wmhunter96/Goma/hardware/pcb/devkit-carrier-v1/sesame-devkit-carrier.step

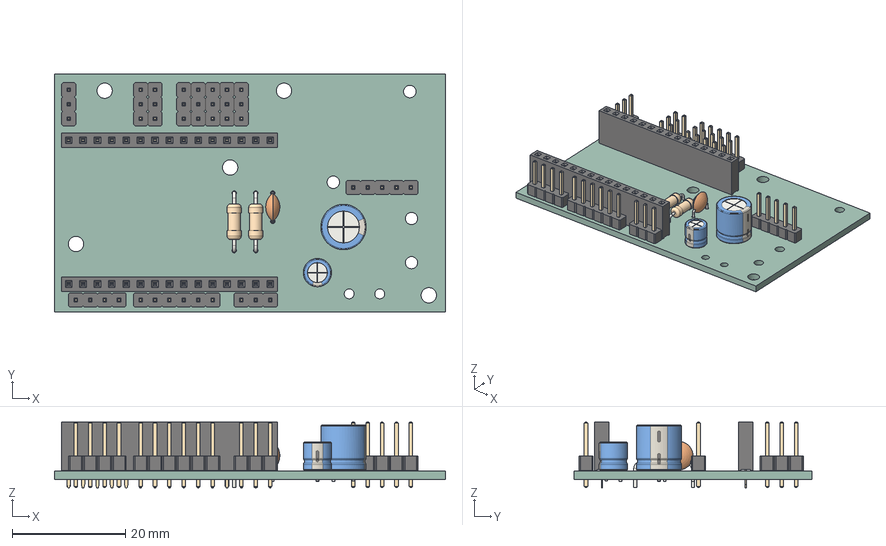
[picture p3: CAD file, 2026-10-20]
hardware/pcb/devkit-carrier-v1/sesame-devkit-carrier.step
69.0 x 42.0 x 11.6 mm
C_Disc_D50mm_W25mm_P500mm
PinHeader_1x04_P254mm_Vertical
PinHeader_1x06_P254mm_Vertical
PinHeader_1x03_P254mm_Vertical x 9
R_Axial_DIN0207_L63mm_D25mm_P1016mm_Horizontal x 2
PinHeader_1x05_P254mm_Vertical
CP_Radial_D80mm_P350mm
PinSocket_1x15_P2.54mm_Vertical x 2
CP_Radial_D50mm_P250mm
sesame-devkit-carrier_PCB
