wmhunter96/Goma/hardware/pcb/devkit-carrier-v1/preview/schematic.pdf

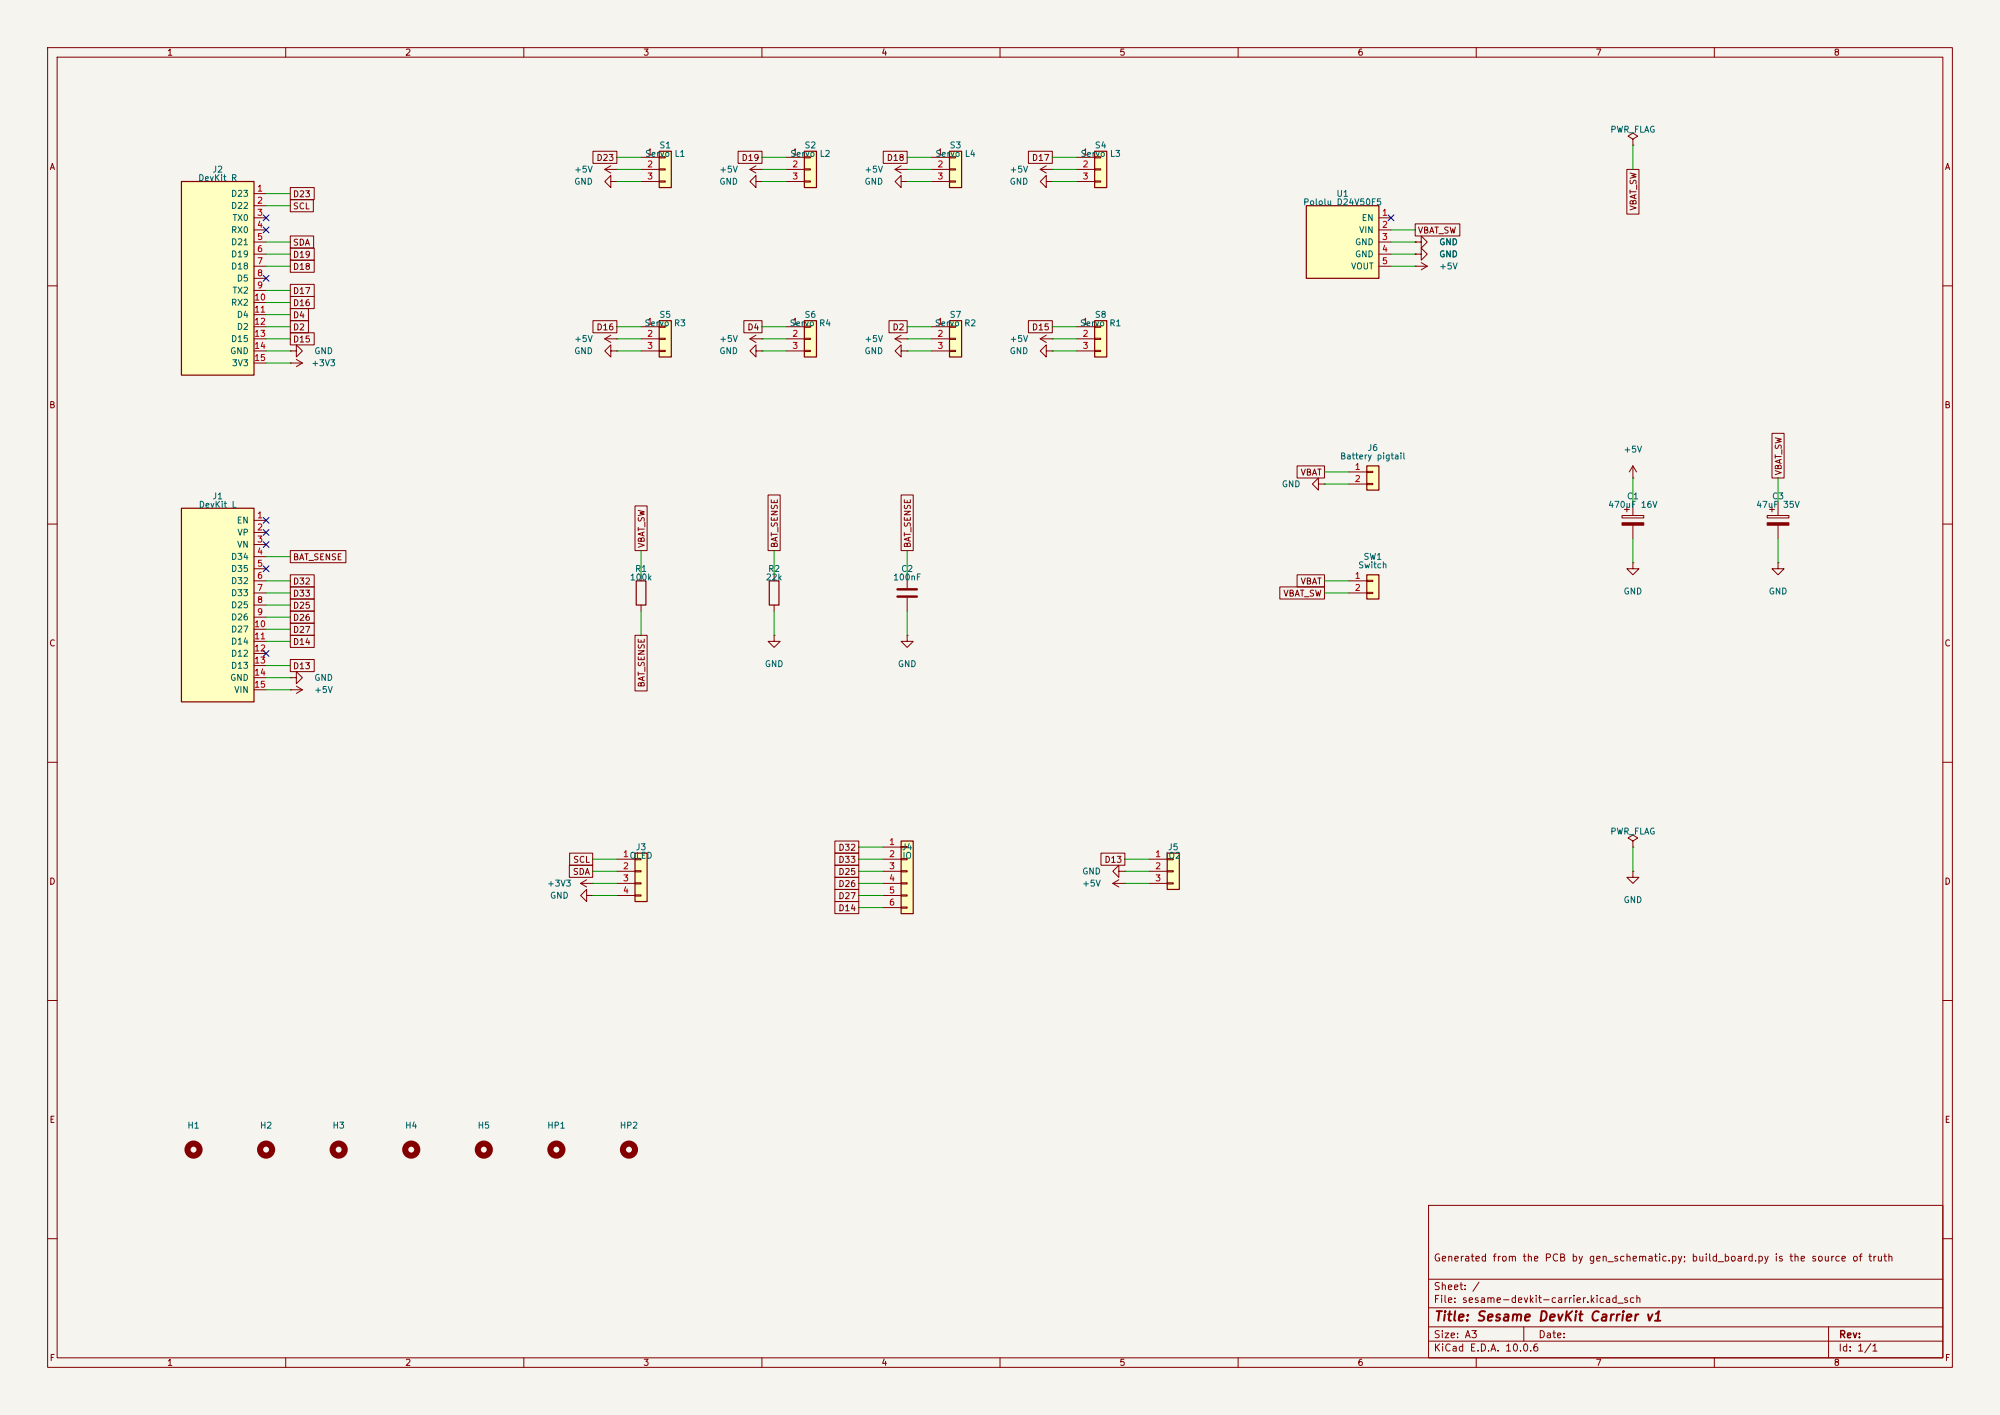
[picture p4: page 1]

Generated from the PCB by gen_schematic.py; build_board.py is the source of truth

Sheet: /
File: sesame-devkit-carrier.kicad_sch
Title: Sesame DevKit Carrier v1

Size: A3 | Rev: | F Date:
KiCad E.D.A. 10.0.6 | Id: 1/1
