wmhunter96/Goma/hardware/pcb/devkit-carrier-v1/preview/bottom_layers.pdf

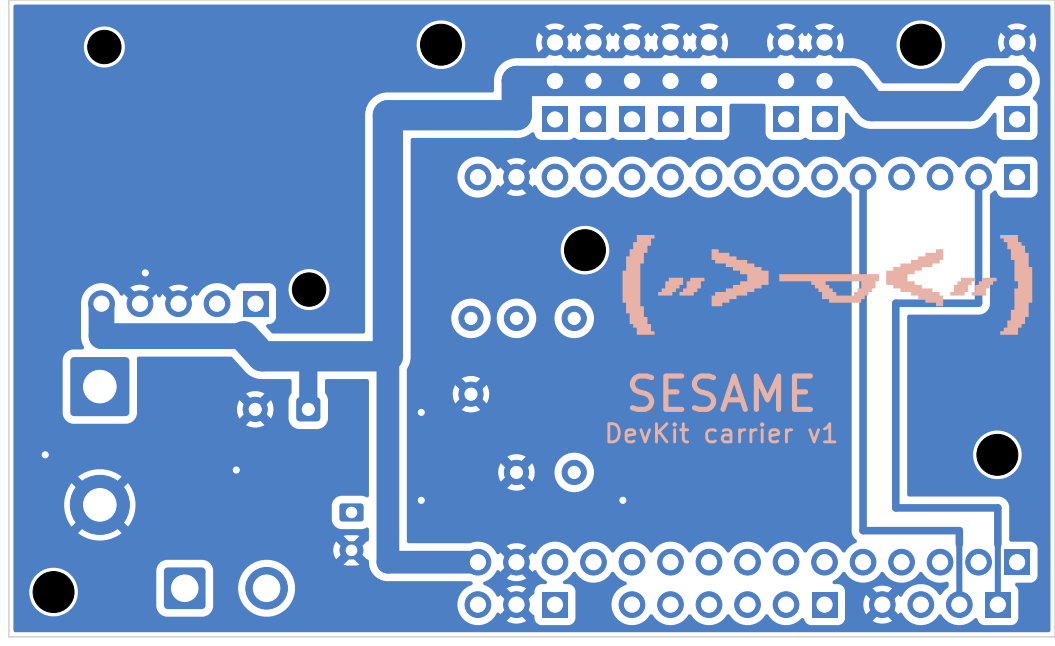
[picture p5: page 1]
