wmhunter96/Goma/hardware/pcb/devkit-carrier-v1/preview/template_1to1.pdf

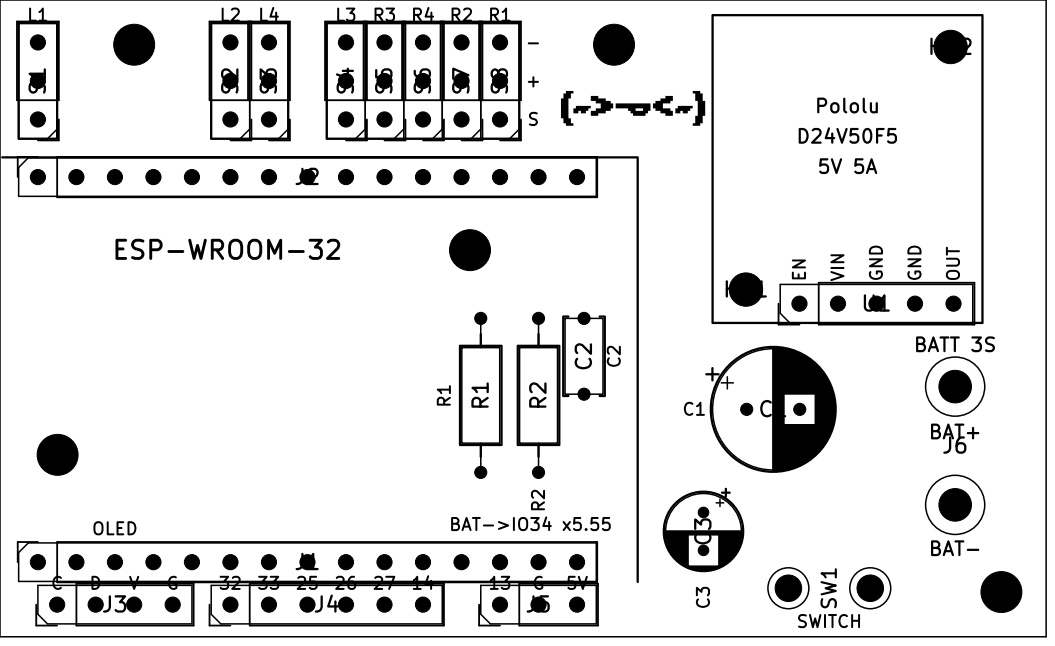
[picture p6: page 1]
