wmhunter96/Goma/hardware/pcb/devkit-carrier-v1/preview/top_layers.pdf

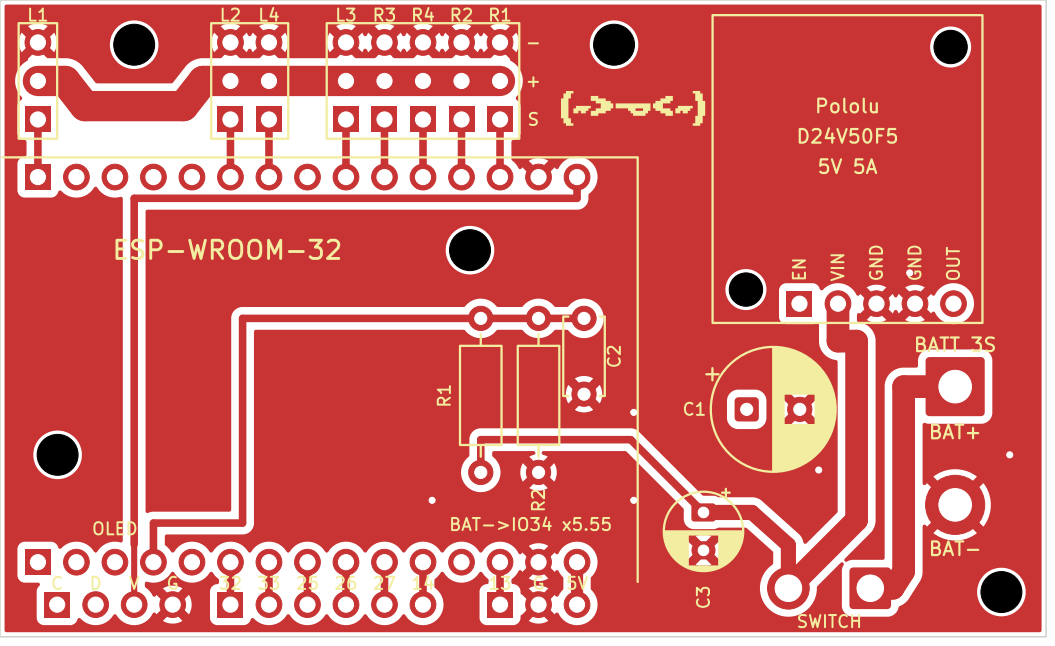
[picture p7: page 1]
