wmhunter96/Goma/hardware/pcb/devkit-carrier-v1/sesame-devkit-carrier.kicad_pcb

## KiCad design hardware/pcb/devkit-carrier-v1/sesame-devkit-carrier.kicad_pcb (2026-10-20)

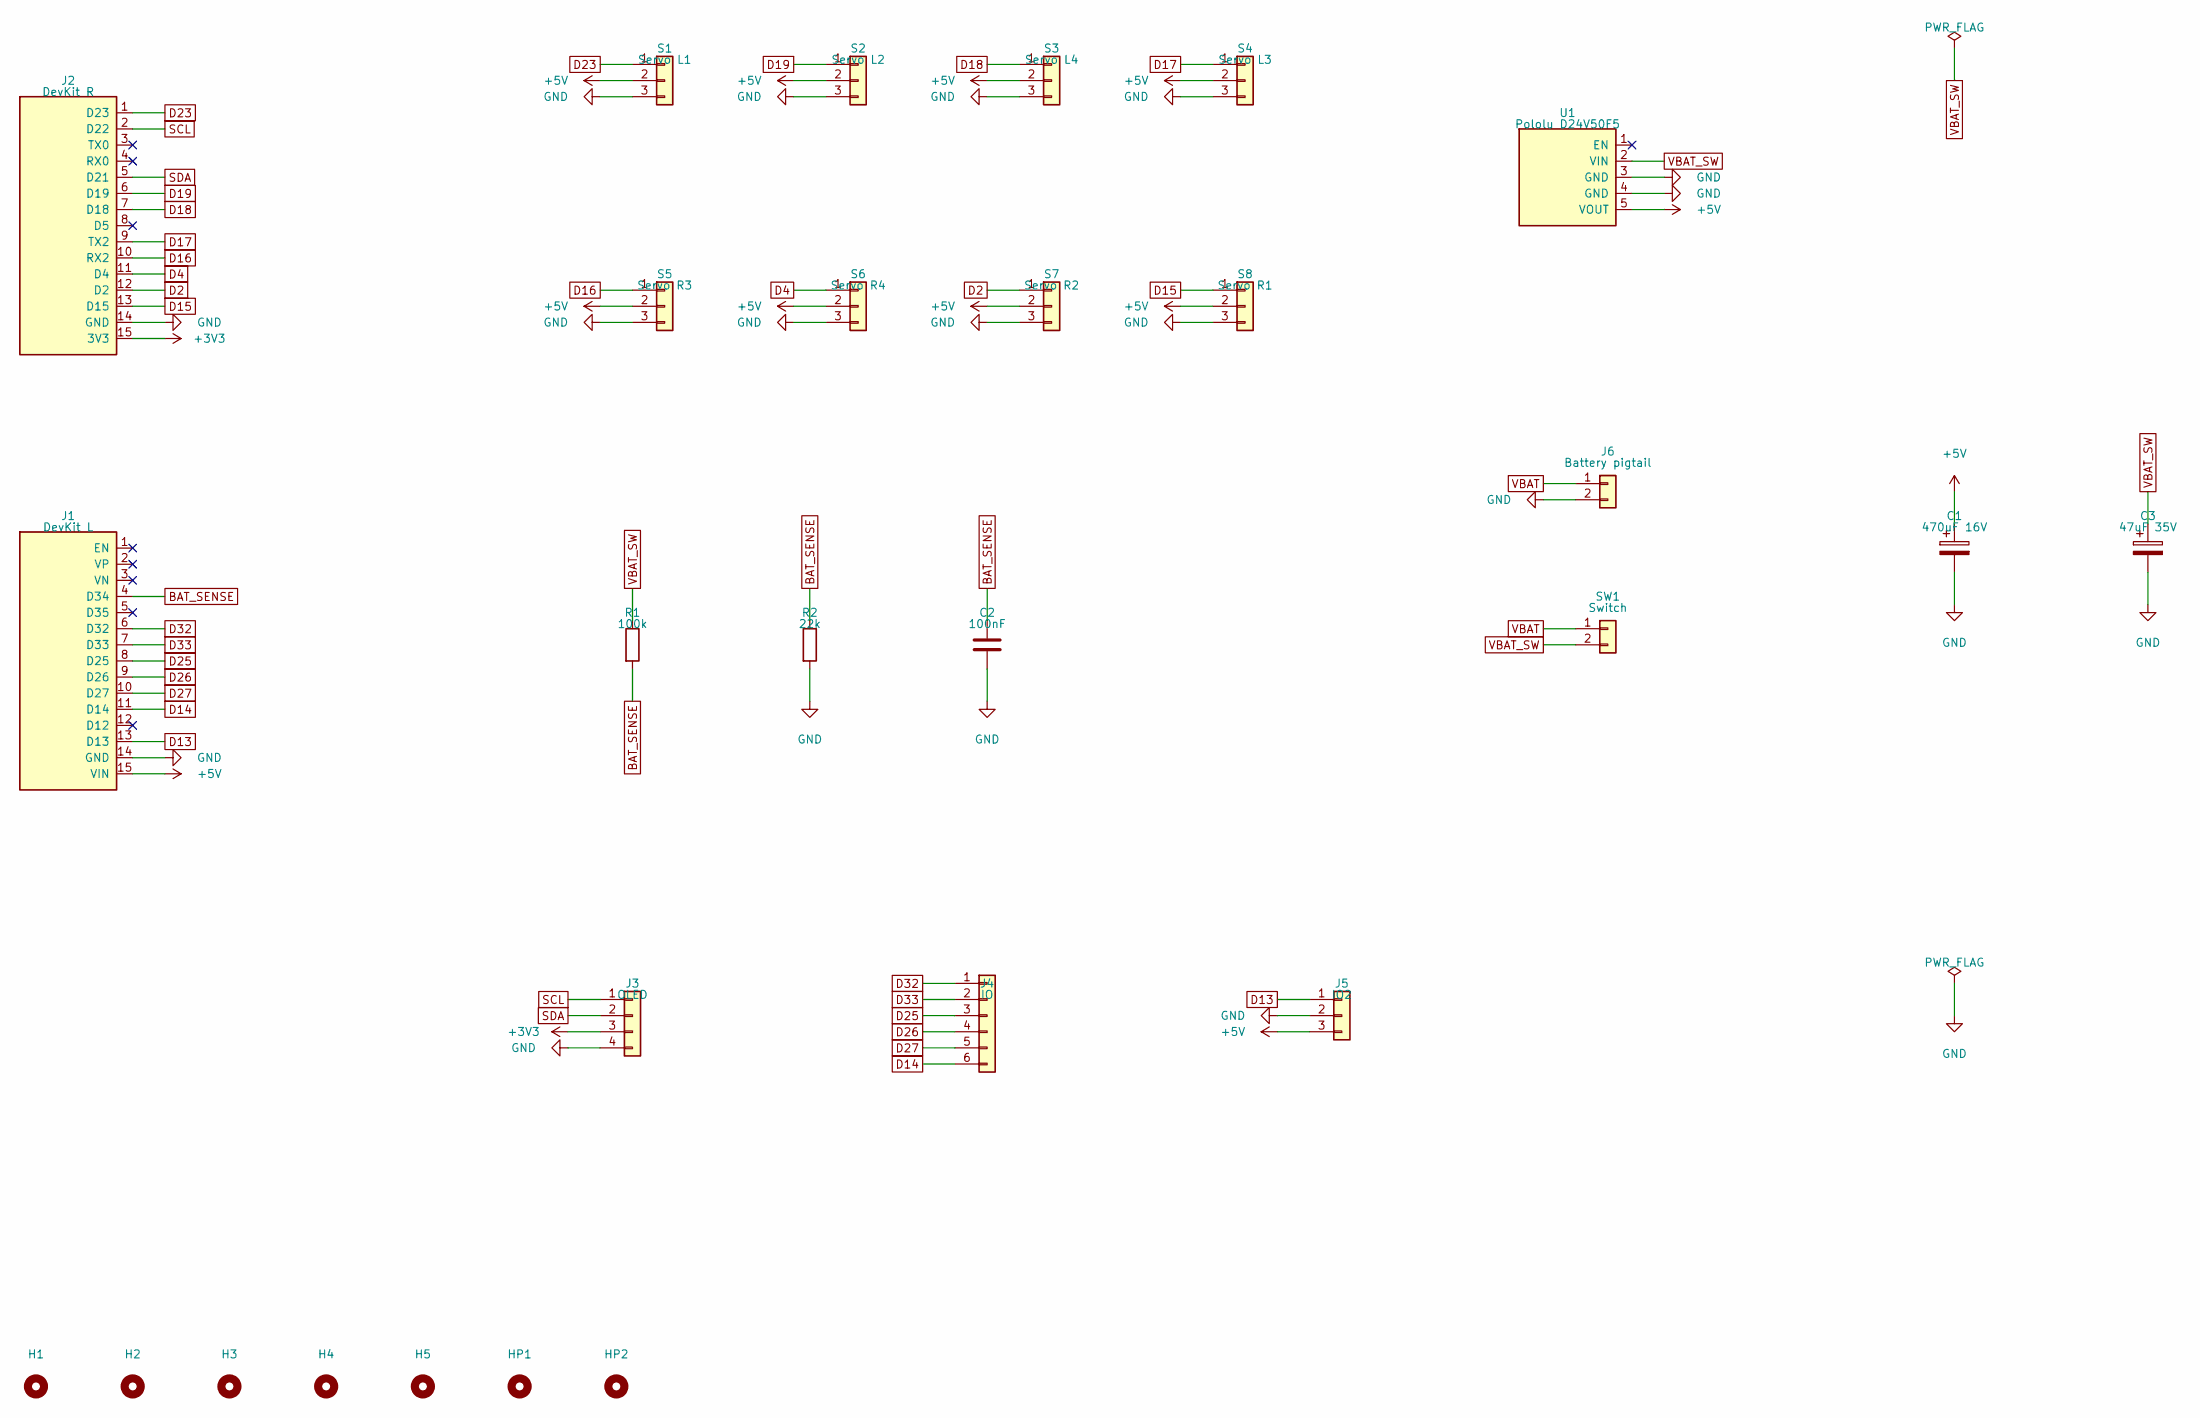
[picture p8: schematic sesame-devkit-carrier.kicad_sch, Sesame DevKit Carrier v1]

Parts:
C1: 470uF 16V; CP_Radial_D8.0mm_P3.50mm
C2: 100nF; C_Disc_D5.0mm_W2.5mm_P5.00mm
C3: 47uF 35V; CP_Radial_D5.0mm_P2.50mm
H1, H2, H3, H4, H5: MountingHole_2.7mm_M2.5
HP1, HP2: MountingHole_2.2mm_M2
J1: DevKit L; PinSocket_1x15_P2.54mm_Vertical_GroupSilk
J2: DevKit R; PinSocket_1x15_P2.54mm_Vertical_GroupSilk
J3: OLED; PinHeader_1x04_P2.54mm_Vertical_GroupSilk
J4: IO; PinHeader_1x06_P2.54mm_Vertical_GroupSilk
J5: IO2; PinHeader_1x03_P2.54mm_Vertical_GroupSilk
J6: Battery pigtail; SolderWire-1.5sqmm_1x02_P7.8mm_D1.7mm_OD3.9mm
R1: 100k; R_Axial_DIN0207_L6.3mm_D2.5mm_P10.16mm_Horizontal
R2: 22k; R_Axial_DIN0207_L6.3mm_D2.5mm_P10.16mm_Horizontal
S1: Servo L1; PinHeader_1x03_P2.54mm_Vertical_GroupSilk
S2: Servo L2; PinHeader_1x03_P2.54mm_Vertical_GroupSilk
S3: Servo L4; PinHeader_1x03_P2.54mm_Vertical_GroupSilk
S4: Servo L3; PinHeader_1x03_P2.54mm_Vertical_GroupSilk
S5: Servo R3; PinHeader_1x03_P2.54mm_Vertical_GroupSilk
S6: Servo R4; PinHeader_1x03_P2.54mm_Vertical_GroupSilk
S7: Servo R2; PinHeader_1x03_P2.54mm_Vertical_GroupSilk
S8: Servo R1; PinHeader_1x03_P2.54mm_Vertical_GroupSilk
SW1: Switch; SolderWire-1sqmm_1x02_P5.4mm_D1.4mm_OD2.7mm
U1: Pololu D24V50F5; PinHeader_1x05_P2.54mm_Vertical_GroupSilk

Connections:
+3V3: J2.15 (3V3), J3.3
+5V: C1.1, J1.15 (VIN), J5.3, S1.2, S2.2, S3.2, S4.2, S5.2, S6.2, S7.2, S8.2, U1.5 (VOUT)
BAT_SENSE: C2.1, J1.4 (D34), R1.2, R2.1
D2: J2.12 (D2), S7.1
D4: J2.11 (D4), S6.1
D13: J1.13 (D13), J5.1
D14: J1.11 (D14), J4.6
D15: J2.13 (D15), S8.1
D16: J2.10 (RX2), S5.1
D17: J2.9 (TX2), S4.1
D18: J2.7 (D18), S3.1
D19: J2.6 (D19), S2.1
D23: J2.1 (D23), S1.1
D25: J1.8 (D25), J4.3
D26: J1.9 (D26), J4.4
D27: J1.10 (D27), J4.5
D32: J1.6 (D32), J4.1
D33: J1.7 (D33), J4.2
GND: C1.2, C2.2, C3.2, J1.14 (GND), J2.14 (GND), J3.4, J5.2, J6.2, R2.2, S1.3, S2.3, S3.3, S4.3, S5.3, S6.3, S7.3, S8.3, U1.3 (GND), U1.4 (GND)
SCL: J2.2 (D22), J3.1
SDA: J2.5 (D21), J3.2
VBAT: J6.1, SW1.1
VBAT_SW: C3.1, R1.1, SW1.2, U1.2 (VIN)

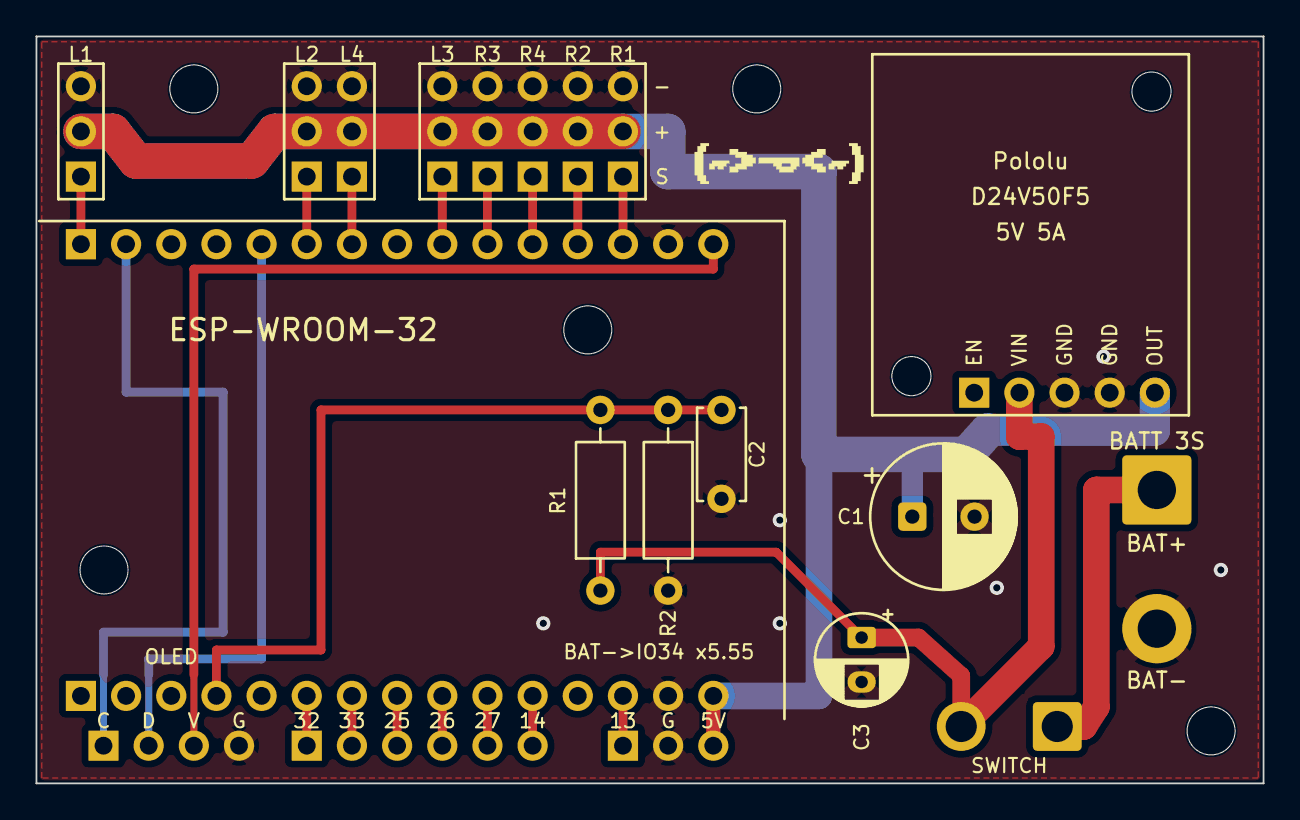
[picture p9: board sesame-devkit-carrier.kicad_pcb from above]

Board: 2 copper layers, 69.0 x 42.0 mm, 28 parts (0 on the bottom side), 23 nets.
