wmhunter96/Goma/(commit log)

2026-10-18 Switch firmware to ESP32 DevKit (Distro V1) pins; add OLED test sketch
2026-10-19 Add DevKit carrier PCB v1 (30-pin ESP32 DevKit, 3S input, Pololu 5V regulator)
    [sesame-devkit-carrier-B_Cu.gbl, sesame-devkit-carrier-B_Mask.gbs, sesame-devkit-carrier-B_Paste.gbp, sesame-devkit-carrier-B_Silkscreen.gbo, sesame-devkit-carrier-Edge_Cuts.gm1, sesame-devkit-carrier-F_Cu.gtl, sesame-devkit-carrier-F_Mask.gts, sesame-devkit-carrier-F_Paste.gtp]
2026-10-19 Add STEP model of DevKit carrier PCB for body CAD
    [sesame-devkit-carrier.step]
2026-10-19 Carrier PCB: 80x42 layout, DevKit USB flush with board edge
    DevKit now lies along the board with its micro-USB at the left edge for
    flashing; servo headers sit directly under their DevKit pins, spare I/O and
    OLED headers along the top edge, power section at the right end.
    [sesame-devkit-carrier-B_Cu.gbl, sesame-devkit-carrier-B_Mask.gbs, sesame-devkit-carrier-B_Paste.gbp, sesame-devkit-carrier-B_Silkscreen.gbo, sesame-devkit-carrier-Edge_Cuts.gm1, sesame-devkit-carrier-F_Cu.gtl, sesame-devkit-carrier-F_Mask.gts, sesame-devkit-carrier-F_Paste.gtp]
2026-10-19 Carrier PCB review fixes: 22k sense resistor, 2mm servo 5V path
    R2 27k -> 22k keeps a full 3S pack (12.6 V) at 2.27 V on GPIO34, inside
    the ESP32 ADC's accurate range. Servo 5V rail and regulator feed widened
    to 2.0 mm for peak servo current.
    [sesame-devkit-carrier-B_Cu.gbl, sesame-devkit-carrier-B_Mask.gbs, sesame-devkit-carrier-B_Paste.gbp, sesame-devkit-carrier-B_Silkscreen.gbo, sesame-devkit-carrier-Edge_Cuts.gm1, sesame-devkit-carrier-F_Cu.gtl, sesame-devkit-carrier-F_Mask.gts, sesame-devkit-carrier-F_Paste.gtp]
2026-10-19 Carrier PCB: replace XT30 with battery pigtail solder pads
    [sesame-devkit-carrier-B_Cu.gbl, sesame-devkit-carrier-B_Mask.gbs, sesame-devkit-carrier-B_Paste.gbp, sesame-devkit-carrier-B_Silkscreen.gbo, sesame-devkit-carrier-Edge_Cuts.gm1, sesame-devkit-carrier-F_Cu.gtl, sesame-devkit-carrier-F_Mask.gts, sesame-devkit-carrier-F_Paste.gtp]
2026-10-19 Carrier PCB: antenna slot and clearance zone
    Cut a slot under the ESP32 antenna and move the regulator, bulk cap,
    battery pads, switch pads and mounting holes to x >= 56 so nothing sits
    within ~8 mm of the antenna end, per Espressif placement guidance.
    [sesame-devkit-carrier-B_Cu.gbl, sesame-devkit-carrier-B_Mask.gbs, sesame-devkit-carrier-B_Paste.gbp, sesame-devkit-carrier-B_Silkscreen.gbo, sesame-devkit-carrier-Edge_Cuts.gm1, sesame-devkit-carrier-F_Cu.gtl, sesame-devkit-carrier-F_Mask.gts, sesame-devkit-carrier-F_Paste.gtp]
2026-10-19 Carrier PCB: DevKit antenna overhangs the board edge
    Turn the DevKit around so its antenna end hangs past the left edge with
    nothing under it; drop the antenna slot. USB now points inward (flash the
    DevKit before plugging it in). Servo headers move to the top strip and the
    I/O + OLED headers to the bottom, still each in line with its pin. Board
    shrinks to 69 x 42 mm.
    [sesame-devkit-carrier-B_Cu.gbl, sesame-devkit-carrier-B_Mask.gbs, sesame-devkit-carrier-B_Paste.gbp, sesame-devkit-carrier-B_Silkscreen.gbo, sesame-devkit-carrier-Edge_Cuts.gm1, sesame-devkit-carrier-F_Cu.gtl, sesame-devkit-carrier-F_Mask.gts, sesame-devkit-carrier-F_Paste.gtp]
2026-10-19 Carrier PCB: Sesame 'cute' face art on both sides
    Face is read pixel-for-pixel from firmware/face-bitmaps.h at build time.
    Battery-sense divider moved toward the DevKit's USB end to clear room for
    the big back-side face.
    [sesame-devkit-carrier-B_Cu.gbl, sesame-devkit-carrier-B_Mask.gbs, sesame-devkit-carrier-B_Paste.gbp, sesame-devkit-carrier-B_Silkscreen.gbo, sesame-devkit-carrier-Edge_Cuts.gm1, sesame-devkit-carrier-F_Cu.gtl, sesame-devkit-carrier-F_Mask.gts, sesame-devkit-carrier-F_Paste.gtp]
2026-10-19 Carrier PCB: electrical audit, widen battery path, double servo 5V rail
    Add audit.py, an independent check of netlist vs spec, firmware pin
    mapping, current capacity, ground fill, polarity and labels. Battery-side
    traces widened to 1.5 mm (3.2 A) for the ~2.8 A peak regulator input; servo
    5V rail doubled on the back layer (2 x 2.0 mm).
    [sesame-devkit-carrier-B_Cu.gbl, sesame-devkit-carrier-B_Mask.gbs, sesame-devkit-carrier-B_Paste.gbp, sesame-devkit-carrier-B_Silkscreen.gbo, sesame-devkit-carrier-Edge_Cuts.gm1, sesame-devkit-carrier-F_Cu.gtl, sesame-devkit-carrier-F_Mask.gts, sesame-devkit-carrier-F_Paste.gtp]
2026-10-19 Carrier PCB: Pololu footprint from official dimension drawing
    Pin row and outline now follow Pololu's D24V50F5 drawing (0J1436): EN 5.73 mm
    from the left edge (was estimated 6.1 mm from a photo), row 1.27 mm up.
    [sesame-devkit-carrier-B_Cu.gbl, sesame-devkit-carrier-B_Mask.gbs, sesame-devkit-carrier-B_Paste.gbp, sesame-devkit-carrier-B_Silkscreen.gbo, sesame-devkit-carrier-Edge_Cuts.gm1, sesame-devkit-carrier-F_Cu.gtl, sesame-devkit-carrier-F_Mask.gts, sesame-devkit-carrier-F_Paste.gtp]
2026-10-19 Carrier PCB: full audit pass, clean DRC, regulator input cap
    - Add C3 (47 uF 35 V) across the regulator input per Pololu's LC-spike
    app note; 5 mm part so it clears the DevKit's USB end.
    - DRC now 0 violations: per-header silkscreen moved to Fab with one
    outline per header group, label collisions fixed, silkscreen lines
    lifted to PCBWay's 0.15 mm minimum, and deliberate side-by-side
    header courtyards allowed in a documented .kicad_dru rule.
    - audit.py extended: C3, capacitor voltage ratings, PCBWay limits, real
    header spacing. README lists every documentation source checked.
    [sesame-devkit-carrier-B_Cu.gbl, sesame-devkit-carrier-B_Mask.gbs, sesame-devkit-carrier-B_Paste.gbp, sesame-devkit-carrier-B_Silkscreen.gbo, sesame-devkit-carrier-Edge_Cuts.gm1, sesame-devkit-carrier-F_Cu.gtl, sesame-devkit-carrier-F_Mask.gts, sesame-devkit-carrier-F_Paste.gtp]
2026-10-19 Carrier PCB: mounting holes at all four corners
    Add top-left and bottom-left holes (threaded between the left-end traces)
    and move the right hole to the top-right corner, so the DevKit end no
    longer cantilevers when servos, the OLED or the DevKit are pushed on.
    [sesame-devkit-carrier-B_Cu.gbl, sesame-devkit-carrier-B_Mask.gbs, sesame-devkit-carrier-B_Paste.gbp, sesame-devkit-carrier-B_Silkscreen.gbo, sesame-devkit-carrier-Edge_Cuts.gm1, sesame-devkit-carrier-F_Cu.gtl, sesame-devkit-carrier-F_Mask.gts, sesame-devkit-carrier-F_Paste.gtp]
2026-10-19 Carrier PCB: 3 mm screw-head keep-out around every mounting hole
    Only ground fill may sit under a screw head. Servo 5V rail dips around the
    top-left hole, the regulator feed comes in below the servo headers instead
    of past the top-middle hole, and SDA is rerouted so the bottom-left hole
    gets its own clear column at (12.4, 31). Keep-out rule areas make DRC
    enforce it; audit.py checks the distance to every non-GND copper item.
    [sesame-devkit-carrier-B_Cu.gbl, sesame-devkit-carrier-B_Mask.gbs, sesame-devkit-carrier-B_Paste.gbp, sesame-devkit-carrier-B_Silkscreen.gbo, sesame-devkit-carrier-Edge_Cuts.gm1, sesame-devkit-carrier-F_Cu.gtl, sesame-devkit-carrier-F_Mask.gts, sesame-devkit-carrier-F_Paste.gtp]
2026-10-19 Carrier PCB: Pololu-matched M2 holes, bottom-left hole near edge
    - Add M2 holes (HP1/HP2) under the Pololu module's own mounting holes so a
    screw can clamp module, printed standoff and carrier; drop the top-right
    M2.5 hole that sat under the module's corner.
    - Reroute SCL off the far left so the bottom-left hole moves to (3.8, 30).
    - Regulator 5V output steps clear of HP1 (M2 keep-out 2.4 mm).
    - Remove the 'ANTENNA overhangs' and 'USB' silkscreen labels.
    [sesame-devkit-carrier-B_Cu.gbl, sesame-devkit-carrier-B_Mask.gbs, sesame-devkit-carrier-B_Paste.gbp, sesame-devkit-carrier-B_Silkscreen.gbo, sesame-devkit-carrier-Edge_Cuts.gm1, sesame-devkit-carrier-F_Cu.gtl, sesame-devkit-carrier-F_Mask.gts, sesame-devkit-carrier-F_Paste.gtp]
2026-10-19 Carrier PCB: refresh preview renders
2026-10-19 Carrier PCB: label DevKit area ESP-WROOM-32, drop front title
    [sesame-devkit-carrier-B_Cu.gbl, sesame-devkit-carrier-B_Mask.gbs, sesame-devkit-carrier-B_Paste.gbp, sesame-devkit-carrier-B_Silkscreen.gbo, sesame-devkit-carrier-Edge_Cuts.gm1, sesame-devkit-carrier-F_Cu.gtl, sesame-devkit-carrier-F_Mask.gts, sesame-devkit-carrier-F_Paste.gtp]
2026-10-19 Carrier PCB: generated schematic, ERC and schematic/PCB parity
    - gen_schematic.py builds sesame-devkit-carrier.kicad_sch from the board,
    with named, electrically typed pins for the DevKit rows and the Pololu
    (Sesame.kicad_sym), power flags, and no-connects on unused pins.
    - Footprints now come from the project library Sesame.pretty (stock
    footprints with the silkscreen tweaks baked in), so the board matches its
    library; footprints link to their symbols; unused pads carry KiCad's
    unconnected-(...) nets. Project sym/fp lib tables make it self-contained.
    - ERC 0/0, DRC with schematic parity 0 violations / 0 footprint errors,
    schematic netlist matches all 86 board pads, audit.py pass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
    [sesame-devkit-carrier-B_Cu.gbl, sesame-devkit-carrier-B_Mask.gbs, sesame-devkit-carrier-B_Paste.gbp, sesame-devkit-carrier-B_Silkscreen.gbo, sesame-devkit-carrier-Edge_Cuts.gm1, sesame-devkit-carrier-F_Cu.gtl, sesame-devkit-carrier-F_Mask.gts, sesame-devkit-carrier-F_Paste.gtp]
2026-10-19 Carrier PCB: kicad-happy review, pan-head edge clearance for M2.5 holes
    kicad-happy flagged H5's courtyard past the board edge; root cause was
    sizing holes for a 4.5 mm socket head instead of a 5.0 mm pan head. H1, H3
    and H5 moved to >= 2.95 mm from the edge, servo rail dip lowered to keep
    H1's 3 mm copper keep-out, battery pads shifted up 1 mm. audit.py checks
    pan-head edge clearance. REVIEW.md records every kicad-happy finding and
    its disposition.
    [sesame-devkit-carrier-B_Cu.gbl, sesame-devkit-carrier-B_Mask.gbs, sesame-devkit-carrier-B_Paste.gbp, sesame-devkit-carrier-B_Silkscreen.gbo, sesame-devkit-carrier-Edge_Cuts.gm1, sesame-devkit-carrier-F_Cu.gtl, sesame-devkit-carrier-F_Mask.gts, sesame-devkit-carrier-F_Paste.gtp]
2026-10-19 Carrier PCB: document socket-head screws for mounting holes
    Hunter uses socket-head cap screws (M2.5 head 4.5 mm, M2 3.8 mm); audit
    and docs check against those. Hole positions unchanged (>= 0.75 mm of
    board and copper margin around each head).
    [sesame-devkit-carrier.kicad_pcb]
2026-10-19 Carrier PCB: widen signal traces to 0.5 mm
    Signal traces 0.3 -> 0.5 mm; necked to 0.4 mm only where they pass between
    2.54 mm socket pins (0.22 mm clearance). Narrowest trace on the board is now
    0.4 mm. 3V3 run nudged 0.2 mm to keep H4's 3 mm keep-out. ERC, DRC+parity,
    audit (new trace-width check) and kicad-happy all re-run clean.
    [sesame-devkit-carrier-B_Cu.gbl, sesame-devkit-carrier-B_Mask.gbs, sesame-devkit-carrier-B_Paste.gbp, sesame-devkit-carrier-B_Silkscreen.gbo, sesame-devkit-carrier-Edge_Cuts.gm1, sesame-devkit-carrier-F_Cu.gtl, sesame-devkit-carrier-F_Mask.gts, sesame-devkit-carrier-F_Paste.gtp]
2026-10-20 Carrier PCB: keep power traces >= 0.4 mm from other nets
    5V servo feed moved into the open strip above the DevKit socket row (0.33 ->
    2.2 mm from its GND/3V3 pins); battery + trace 0.30 -> 0.70 mm from BAT-;
    regulator output 0.25 -> 0.53 mm from BAT+ (1.7 mm wide over its 10 mm run
    between the module pins and BAT+). audit.py enforces >= 0.4 mm.
    [sesame-devkit-carrier-B_Cu.gbl, sesame-devkit-carrier-B_Mask.gbs, sesame-devkit-carrier-B_Paste.gbp, sesame-devkit-carrier-B_Silkscreen.gbo, sesame-devkit-carrier-Edge_Cuts.gm1, sesame-devkit-carrier-F_Cu.gtl, sesame-devkit-carrier-F_Mask.gts, sesame-devkit-carrier-F_Paste.gtp]
2026-10-20 Carrier README: short-finding guide for this board, fix stale schematic note
2026-10-20 Carrier PCB: widen C3 pad gap to 0.8 mm, route battery-sense tap away from socket pins
    Short-risk analysis found the two worst spots: C3's pads (battery + to GND)
    were 0.40 mm apart, and the 12.6 V sense tap passed 0.22 mm from D13
    between socket pins. C3 pads narrowed along the pitch (gap 0.80 mm, now
    the board minimum); sense tap runs from C3 between the socket rows to R1.
    ERC/DRC/parity/audit clean, kicad-happy unchanged.
    [sesame-devkit-carrier-B_Cu.gbl, sesame-devkit-carrier-B_Mask.gbs, sesame-devkit-carrier-B_Paste.gbp, sesame-devkit-carrier-B_Silkscreen.gbo, sesame-devkit-carrier-Edge_Cuts.gm1, sesame-devkit-carrier-F_Cu.gtl, sesame-devkit-carrier-F_Mask.gts, sesame-devkit-carrier-F_Paste.gtp]
2026-10-20 Carrier PCB: wider short-risk margins and a short_check.py gate
    Ground fill 0.5 mm back from all copper (was 0.3), C3 on 2.5 mm pitch
    with narrowed pads (1.3 mm gap across the battery), R1/R2 battery-to-GND
    pads 2.2 mm apart, stitching vias moved off the 5V feed. short_check.py
    (plain Python, no KiCad) enforces the margins. ERC/DRC/parity/audit clean,
    kicad-happy unchanged.
    [sesame-devkit-carrier-B_Cu.gbl, sesame-devkit-carrier-B_Mask.gbs, sesame-devkit-carrier-B_Paste.gbp, sesame-devkit-carrier-B_Silkscreen.gbo, sesame-devkit-carrier-Edge_Cuts.gm1, sesame-devkit-carrier-F_Cu.gtl, sesame-devkit-carrier-F_Mask.gts, sesame-devkit-carrier-F_Paste.gtp]
2026-10-31 Firmware: battery monitoring on GPIO34 (carrier divider)
    OLED voltage overlay, web UI readout, battery object in /api/status,
    low warning at 10.5 V and latched servo cutoff after 10 s below 9.9 V.
    Readings outside 5-14 V count as no pack, so USB/hand-wired builds are
    unaffected. Serial 'bat' command prints raw pin mV for calibration.
